amirmun99/3x3-Control-Pad/pinout.md

# In order to use the script as is, wire your pico following this pinout:

Raspberry Pi Pico Pinout Layout
--------------------------------

OLED Display (0.96 Inch, 128x64):
- SDA (Serial Data): GPIO18
- SCL (Serial Clock): GPIO19
- VCC (Power): 3.3V or 5V (depending on OLED module)
- GND (Ground): GND

Switches (9 mechanical switches):
- Switch 1: GPIO6
- Switch 2: GPIO7
- Switch 3: GPIO8
- Switch 4: GPIO3
- Switch 5: GPIO4
- Switch 6: GPIO5
- Switch 7: GPIO0
- Switch 8: GPIO1
- Switch 9: GPIO2

Rotary Encoders:
- Rotary Encoder 1 (Volume Control):
  - Out A: GPIO15
  - Out B: GPIO14
  - Switch: GPIO13

- Rotary Encoder 2 (Layer Selector):
  - Out A: GPIO10
  - Out B: GPIO11
  - Switch: GPIO9
