amirmun99/3x3-Control-Pad/3x3 Control Pad Bottom.stl

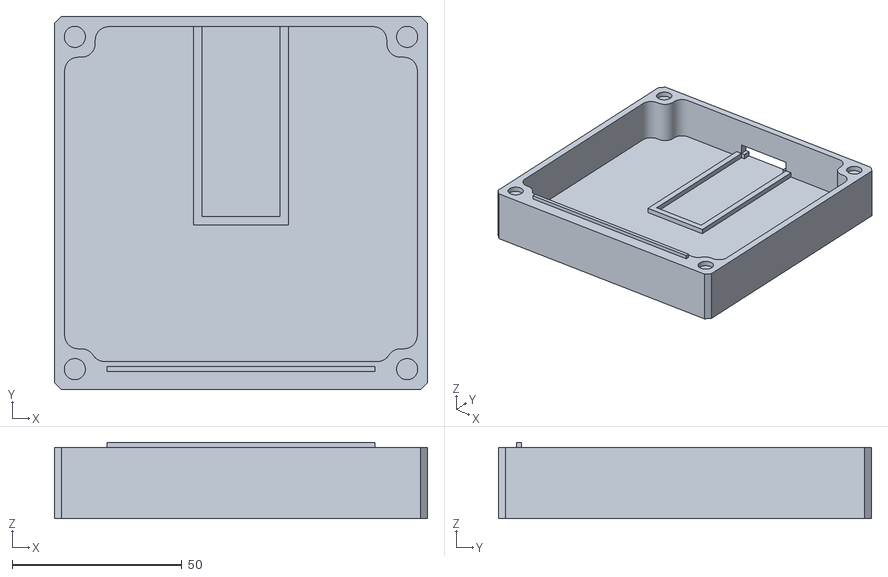
[picture p1: CAD file, 2024-01-22]
3x3 Control Pad Bottom.stl
110.0 x 110.0 x 22.5
