amirmun99/3x3-Control-Pad/3x3 Control Pad Top.stl

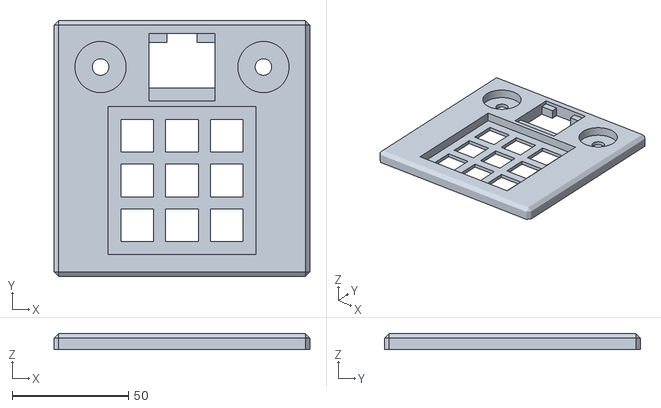
[picture p2: CAD file, 2024-01-22]
3x3 Control Pad Top.stl
110.0 x 110.0 x 7.00
