amirmun99/3x3-Control-Pad/3x3 Control Pad_.step

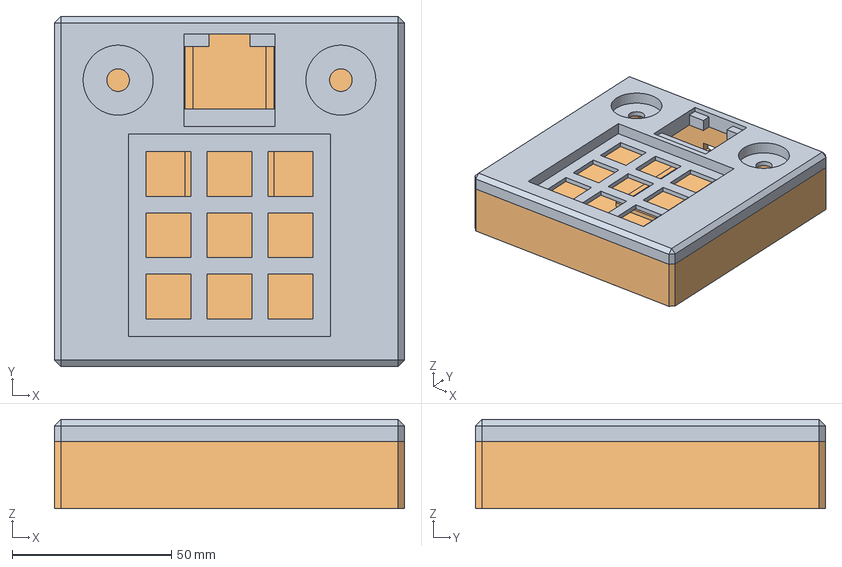
[picture p3: CAD file, 2024-01-22]
3x3 Control Pad_.step
110.0 x 110.0 x 28.0 mm
